fujiy/ModularNixie/hardware/NixiePower.brd

## EAGLE design hardware/NixiePower.brd (2020-12-17)

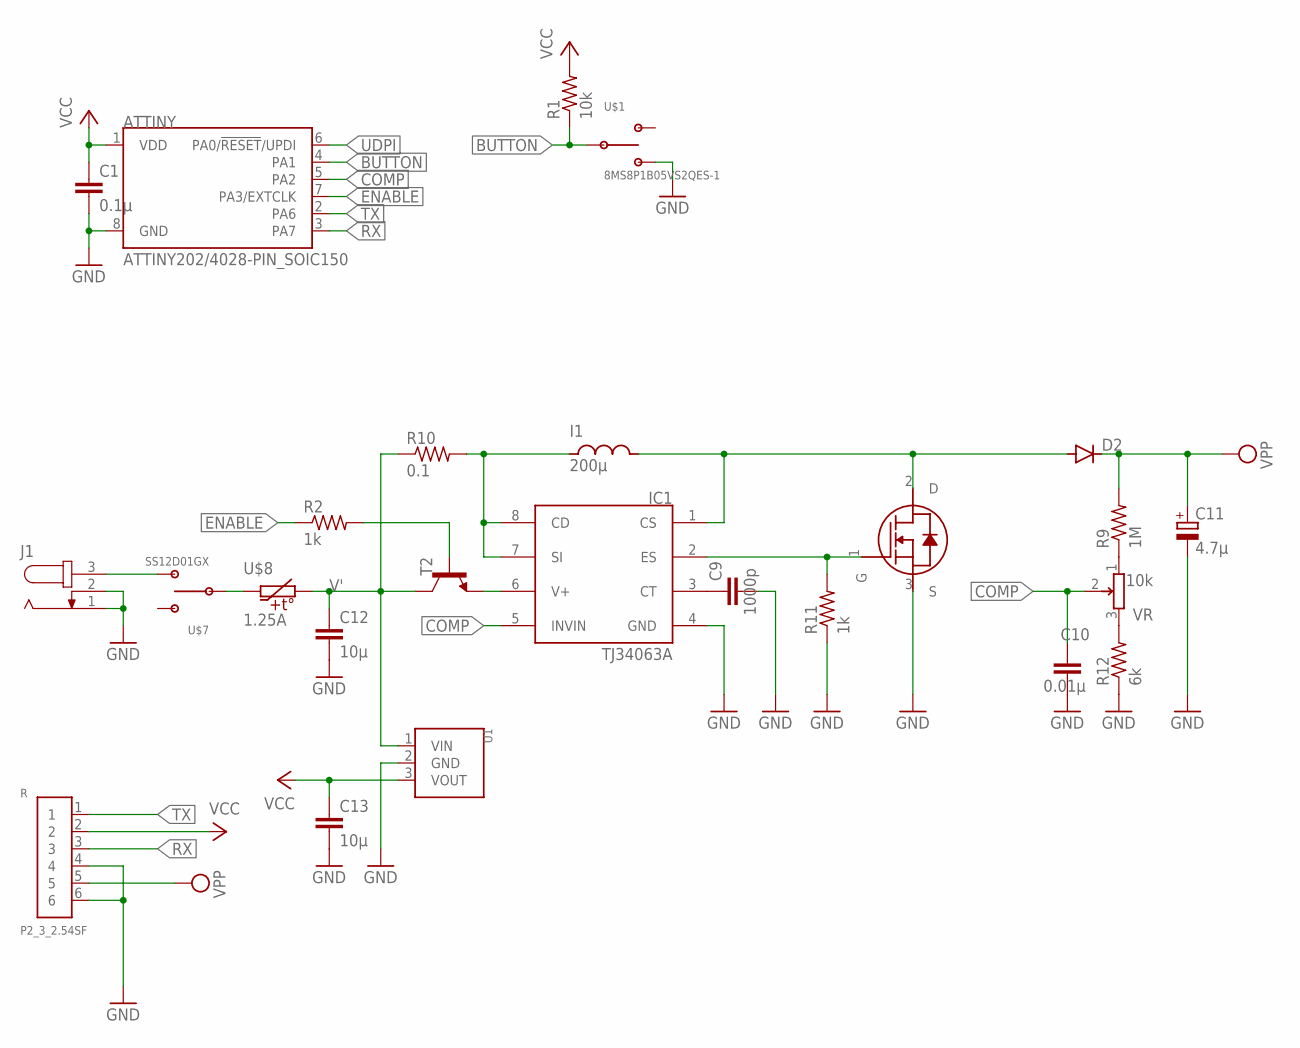
[picture p1: schematic NixiePower.sch]

Parts:
ATTINY: ATTINY202/4028-PIN_SOIC150; SOIC127P600X175-8N
C1: 0.1µ; C0603
C9: 1000p; C0603
C10: 0.01µ; C0603
C11: 4.7µ; E5-10,5
C12, C13: 10µ; C0603
D2: DIODE-DO15-12; DO15-12
I1: 200µ; NR10050
IC1: TJ34063A; SOP8
J1: JACK-PLUG1; SPC4078
R: P2_3_2.54SF
R1: 10k; R0603
R2, R11: 1k; R0603
R9: 1M; R0603
R10: 0.1; R0603
R12: 6k; R0603
T1: R6006AND; CPT3
T2: -NPN-SOT23-EBC; SOT23-EBC
U1: VX078XX-500
U$1: 8MS8P1B05VS2QES-1
U$7: SS12D01GX
U$8: 1.25A; SMD1812P
VR: 10k; RK09D

Connections:
BUTTON: ATTINY.4 (PA1), R1.1, U$1.2 (C)
COMP: ATTINY.5 (PA2), C10.1, IC1.5 (INVIN), VR.2
ENABLE: ATTINY.7 (PA3/EXTCLK), R2.1
GND: ATTINY.8 (GND), C1.2, C9.2, C10.2, C11.-, C12.2, C13.2, IC1.4 (GND), J1.1, J1.2, R.4, R.6, R11.1, R12.1, T1.3 (S), U1.2 (GND), U$1.3 (B)
unnamed: IC1.6 (V+), T2.E
unnamed: R2.2, T2.B
unnamed: U$7.2 (C), U$8.1
unnamed: J1.3, U$7.3 (B)
unnamed: D2.A, I1.2, IC1.1 (CS), T1.2 (D)
unnamed: C9.1, IC1.3 (CT)
unnamed: I1.1, IC1.7 (SI), IC1.8 (CD), R10.2
unnamed: IC1.2 (ES), R11.2, T1.1 (G)
unnamed: R9.1, VR.1 (3)
unnamed: R12.2, VR.3 (1)
RX: ATTINY.3 (PA7), R.3
TX: ATTINY.2 (PA6), R.1
UDPI: ATTINY.6 (PA0/!RESET!/UPDI)
V': C12.1, R10.1, T2.C, U1.1 (VIN), U$8.2
VCC: ATTINY.1 (VDD), C1.1, C13.1, R.2, R1.2, U1.3 (VOUT)
VPP: C11.+, D2.C, R.5, R9.2

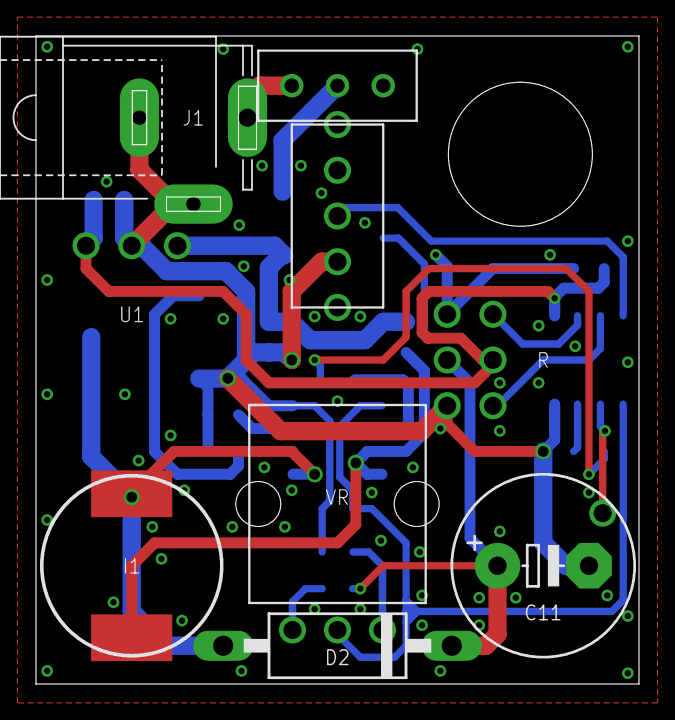
[picture p2: board NixiePower.brd from above]

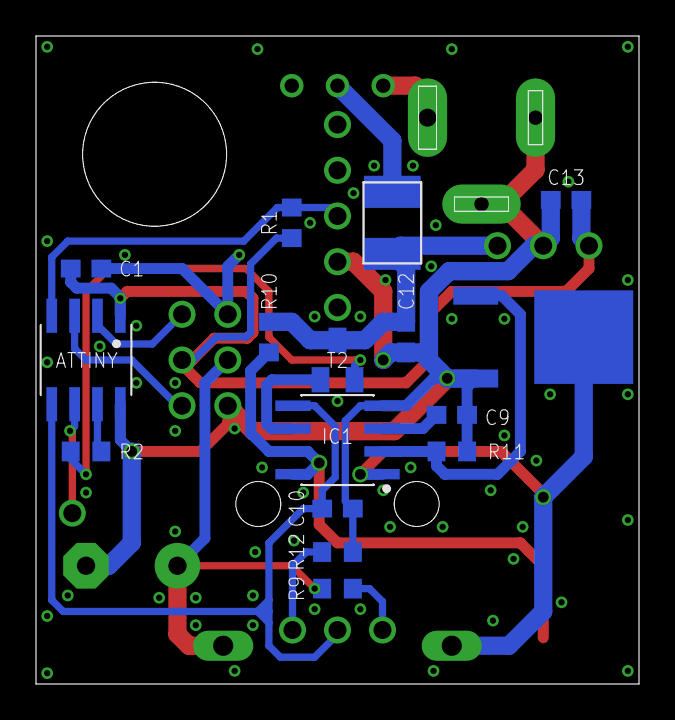
[picture p3: board NixiePower.brd from below]

Board: 2 copper layers, 33.5 x 36.0 mm, 25 parts (16 on the bottom side), 19 nets.
