fujiy/ModularNixie/hardware/IN-12.brd

## EAGLE design hardware/IN-12.brd (2020-12-09)

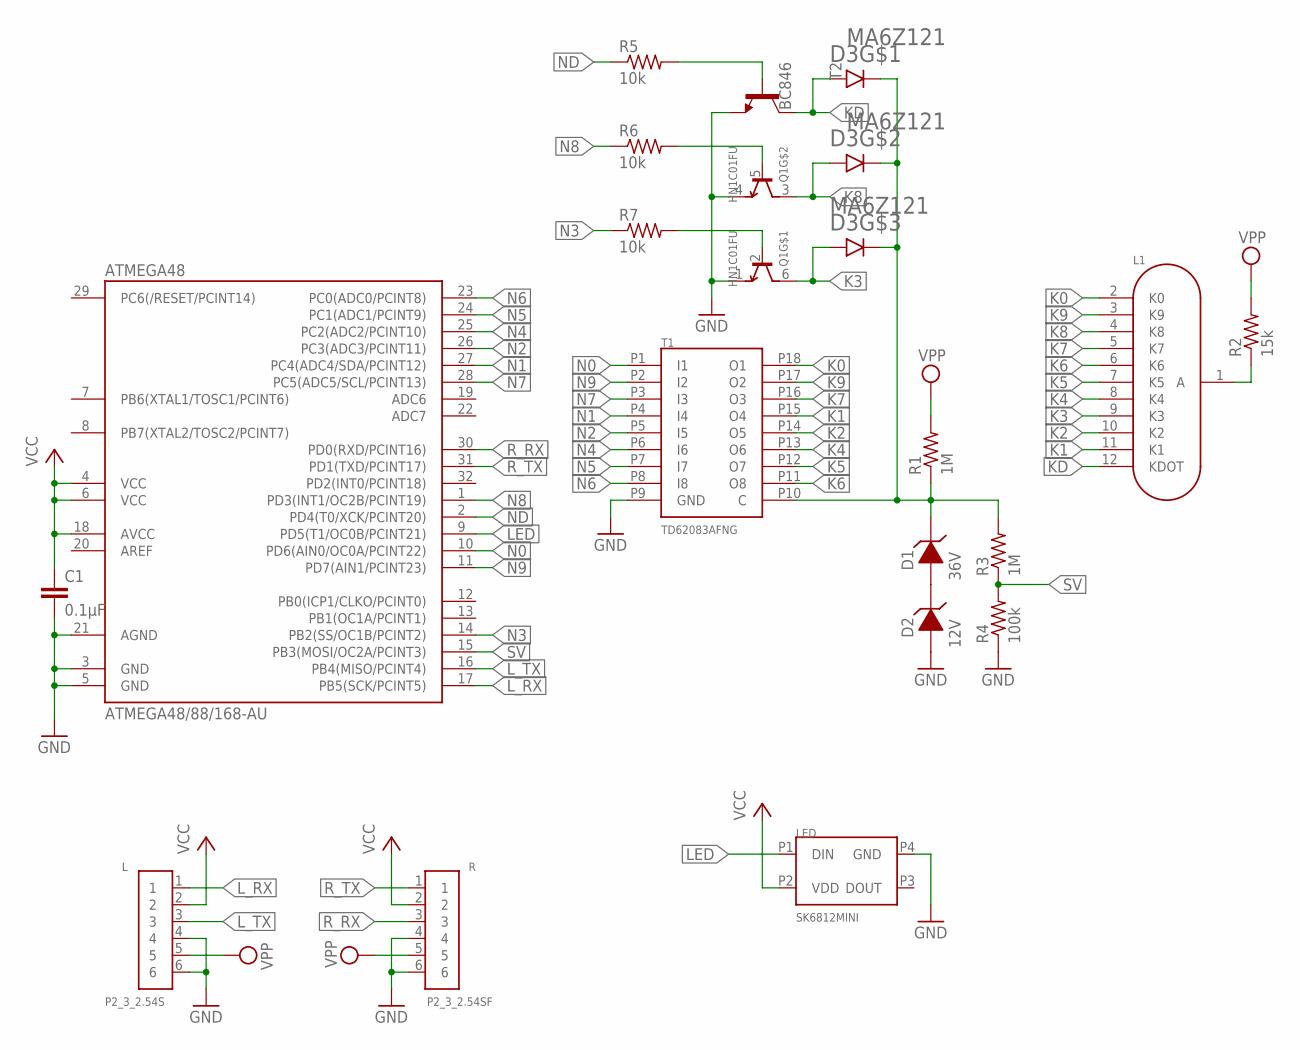
[picture p4: schematic IN-12.sch]

Parts:
ATMEGA48: ATMEGA48/88/168-AU; TQFP32-08
C1: 0.1µF; C0603
D1: 36V; S-MINI-2P
D2: 12V; S-MINI-2P
D3: MA6Z121; SMINI6-F1
L: P2_3_2.54S
L1: IN-12B_PS; IN-12_PS
LED: SK6812MINI; SK68XXMINI
Q1: HN1C01FU; SOT-363
R: P2_3_2.54SF
R1, R3: 1M; R0603
R2: 15k; R1206
R4: 100k; R0603
R5, R6, R7: 10k; R0603
T1: TD62083AFNG; SSOP18-P-225-0.65
T2: BC846; SOT23

Connections:
GND: ATMEGA48.3 (GND), ATMEGA48.5 (GND), ATMEGA48.21 (AGND), C1.2, D2.1 (A), L.4, L.6, LED.P4 (GND), Q1.1 (E), Q1.4 (E), R.4, R.6, R4.1, T1.P9 (GND), T2.2 (E)
K0: L1.2 (K0), T1.P18 (O1)
K1: L1.11 (K1), T1.P15 (O4)
K2: L1.10 (K2), T1.P14 (O5)
K3: D3.P3 (A), L1.9 (K3), Q1.6 (C)
K4: L1.8 (K4), T1.P13 (O6)
K5: L1.7 (K5), T1.P12 (O7)
K6: L1.6 (K6), T1.P11 (O8)
K7: L1.5 (K7), T1.P16 (O3)
K8: D3.P2 (A), L1.4 (K8), Q1.3 (C)
K9: L1.3 (K9), T1.P17 (O2)
KD: D3.P1 (A), L1.12 (KDOT), T2.3 (C)
LED: ATMEGA48.9 (PD5(T1/OC0B/PCINT21)), LED.P1 (DIN)
L_RX: ATMEGA48.17 (PB5(SCK/PCINT5)), L.1
L_TX: ATMEGA48.16 (PB4(MISO/PCINT4)), L.3
N0: ATMEGA48.10 (PD6(AIN0/OC0A/PCINT22)), T1.P1 (I1)
N1: ATMEGA48.27 (PC4(ADC4/SDA/PCINT12)), T1.P4 (I4)
N2: ATMEGA48.26 (PC3(ADC3/PCINT11)), T1.P5 (I5)
N3: ATMEGA48.14 (PB2(SS/OC1B/PCINT2)), R7.1
N4: ATMEGA48.25 (PC2(ADC2/PCINT10)), T1.P6 (I6)
N5: ATMEGA48.24 (PC1(ADC1/PCINT9)), T1.P7 (I7)
N6: ATMEGA48.23 (PC0(ADC0/PCINT8)), T1.P8 (I8)
N7: ATMEGA48.28 (PC5(ADC5/SCL/PCINT13)), T1.P3 (I3)
N8: ATMEGA48.1 (PD3(INT1/OC2B/PCINT19)), R6.1
N9: ATMEGA48.11 (PD7(AIN1/PCINT23)), T1.P2 (I2)
unnamed: D1.1 (A), D2.2 (C)
unnamed: D1.2 (C), D3.P4 (C), D3.P5 (C), D3.P6 (C), R1.1, R3.2, T1.P10 (C)
unnamed: L1.1 (A), R2.1
unnamed: Q1.2 (B), R7.2
unnamed: Q1.5 (B), R6.2
unnamed: R5.2, T2.1 (B)
ND: ATMEGA48.2 (PD4(T0/XCK/PCINT20)), R5.1
R_RX: ATMEGA48.30 (PD0(RXD/PCINT16)), R.3
R_TX: ATMEGA48.31 (PD1(TXD/PCINT17)), R.1
SV: ATMEGA48.15 (PB3(MOSI/OC2A/PCINT3)), R3.1, R4.2
VCC: ATMEGA48.4 (VCC), ATMEGA48.6 (VCC), ATMEGA48.18 (AVCC), C1.1, L.2, LED.P2 (VDD), R.2
VPP: L.5, R.5, R1.2, R2.2

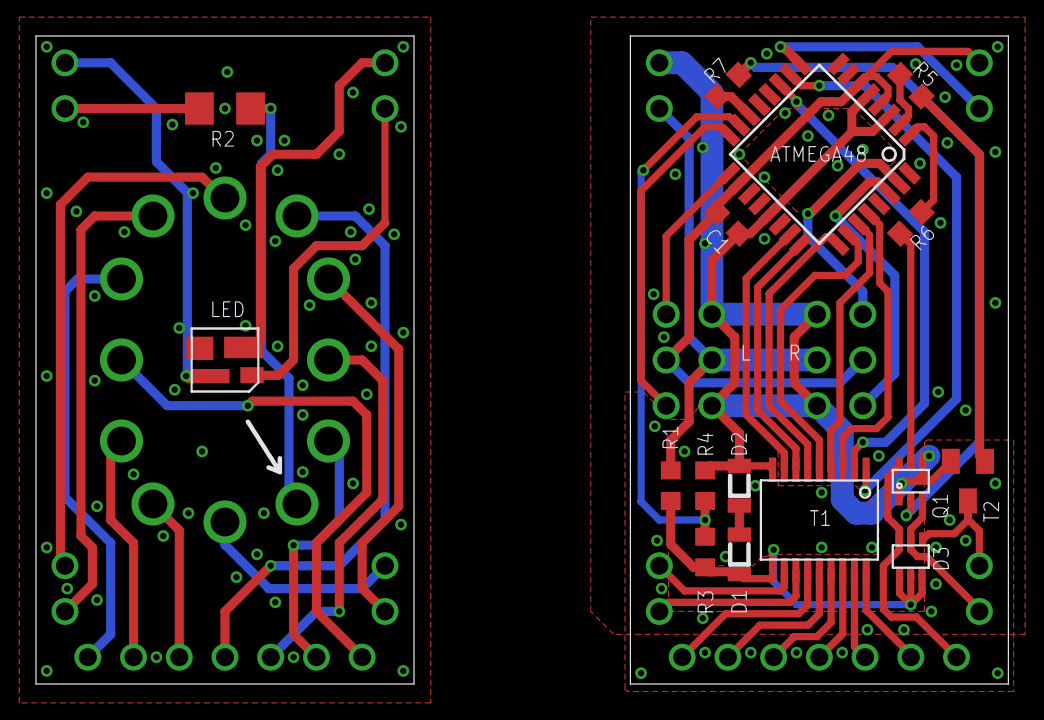
[picture p5: board IN-12.brd from above]

Board: 2 copper layers, 21.0 x 36.0 mm, 19 parts (1 on the bottom side), 37 nets.
