fujiy/ModularNixie/hardware/ColonRelay.brd

## EAGLE design hardware/ColonRelay.brd (2020-12-09)

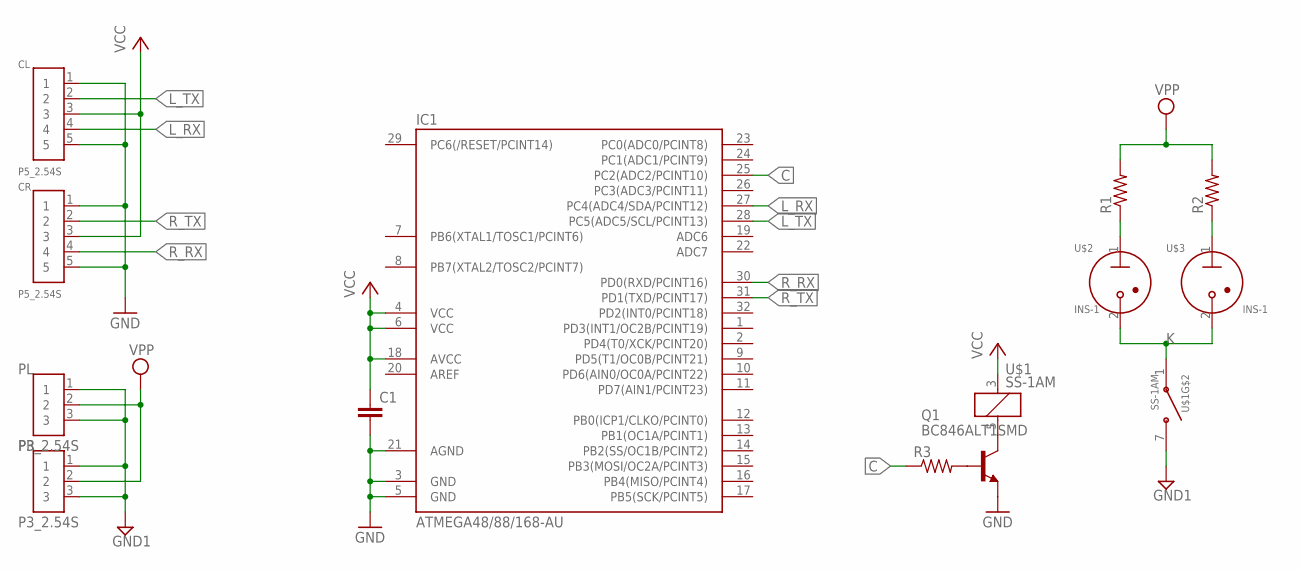
[picture p6: schematic ColonRelay.sch]

Parts:
C1: C-EUC0603K; C0603K
CL: P5_2.54S
CR: P5_2.54S
IC1: ATMEGA48/88/168-AU; TQFP32-08
PL: P3_2.54S
PR: P3_2.54S
Q1: BC846ALT1SMD; SOT23
R1, R2: R-US_R1206; R1206
R3: R-US_R0603; R0603
U$1: SS-1AM; SS-1****M
U$2, U$3: INS-1

Connections:
C: IC1.25 (PC2(ADC2/PCINT10)), R3.1
GND: C1.2, CL.1, CL.5, CR.1, CR.5, IC1.3 (GND), IC1.5 (GND), IC1.21 (AGND), Q1.2 (E)
GND1: PL.1, PL.3, PR.1, PR.3, U$1.7
K: U$1.1, U$2.2 (C), U$3.2 (C)
L_RX: CL.4, IC1.27 (PC4(ADC4/SDA/PCINT12))
L_TX: CL.2, IC1.28 (PC5(ADC5/SCL/PCINT13))
unnamed: Q1.3 (C), U$1.5 (2)
unnamed: R2.1, U$3.1 (A)
unnamed: R1.1, U$2.1 (A)
unnamed: Q1.1 (B), R3.2
R_RX: CR.4, IC1.30 (PD0(RXD/PCINT16))
R_TX: CR.2, IC1.31 (PD1(TXD/PCINT17))
VCC: C1.1, CL.3, CR.3, IC1.4 (VCC), IC1.6 (VCC), IC1.18 (AVCC), U$1.3 (1)
VPP: PL.2, PR.2, R1.2, R2.2

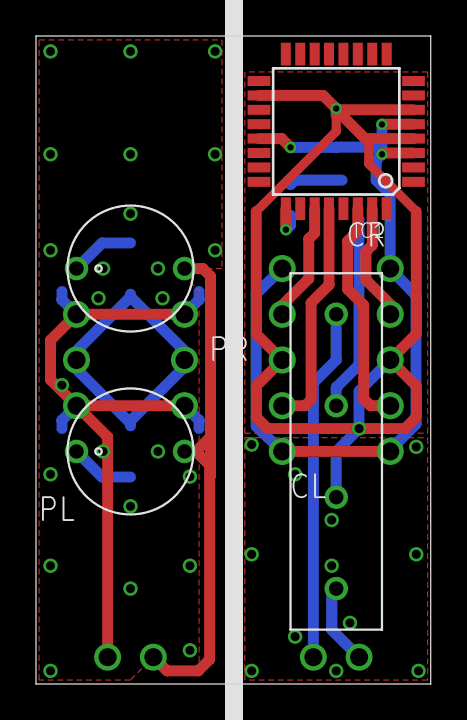
[picture p7: board ColonRelay.brd from above]

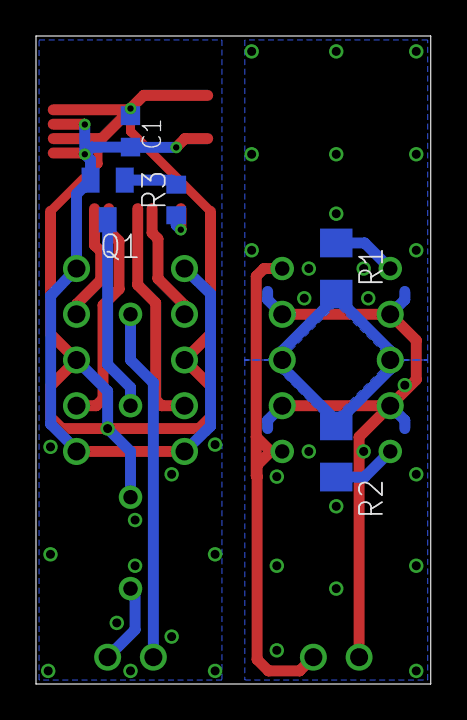
[picture p8: board ColonRelay.brd from below]

Board: 2 copper layers, 21.9 x 36.0 mm, 13 parts (5 on the bottom side), 14 nets.
