fujiy/ModularNixie/hardware/IN-12Relay.brd

## EAGLE design hardware/IN-12Relay.brd (2020-12-09)

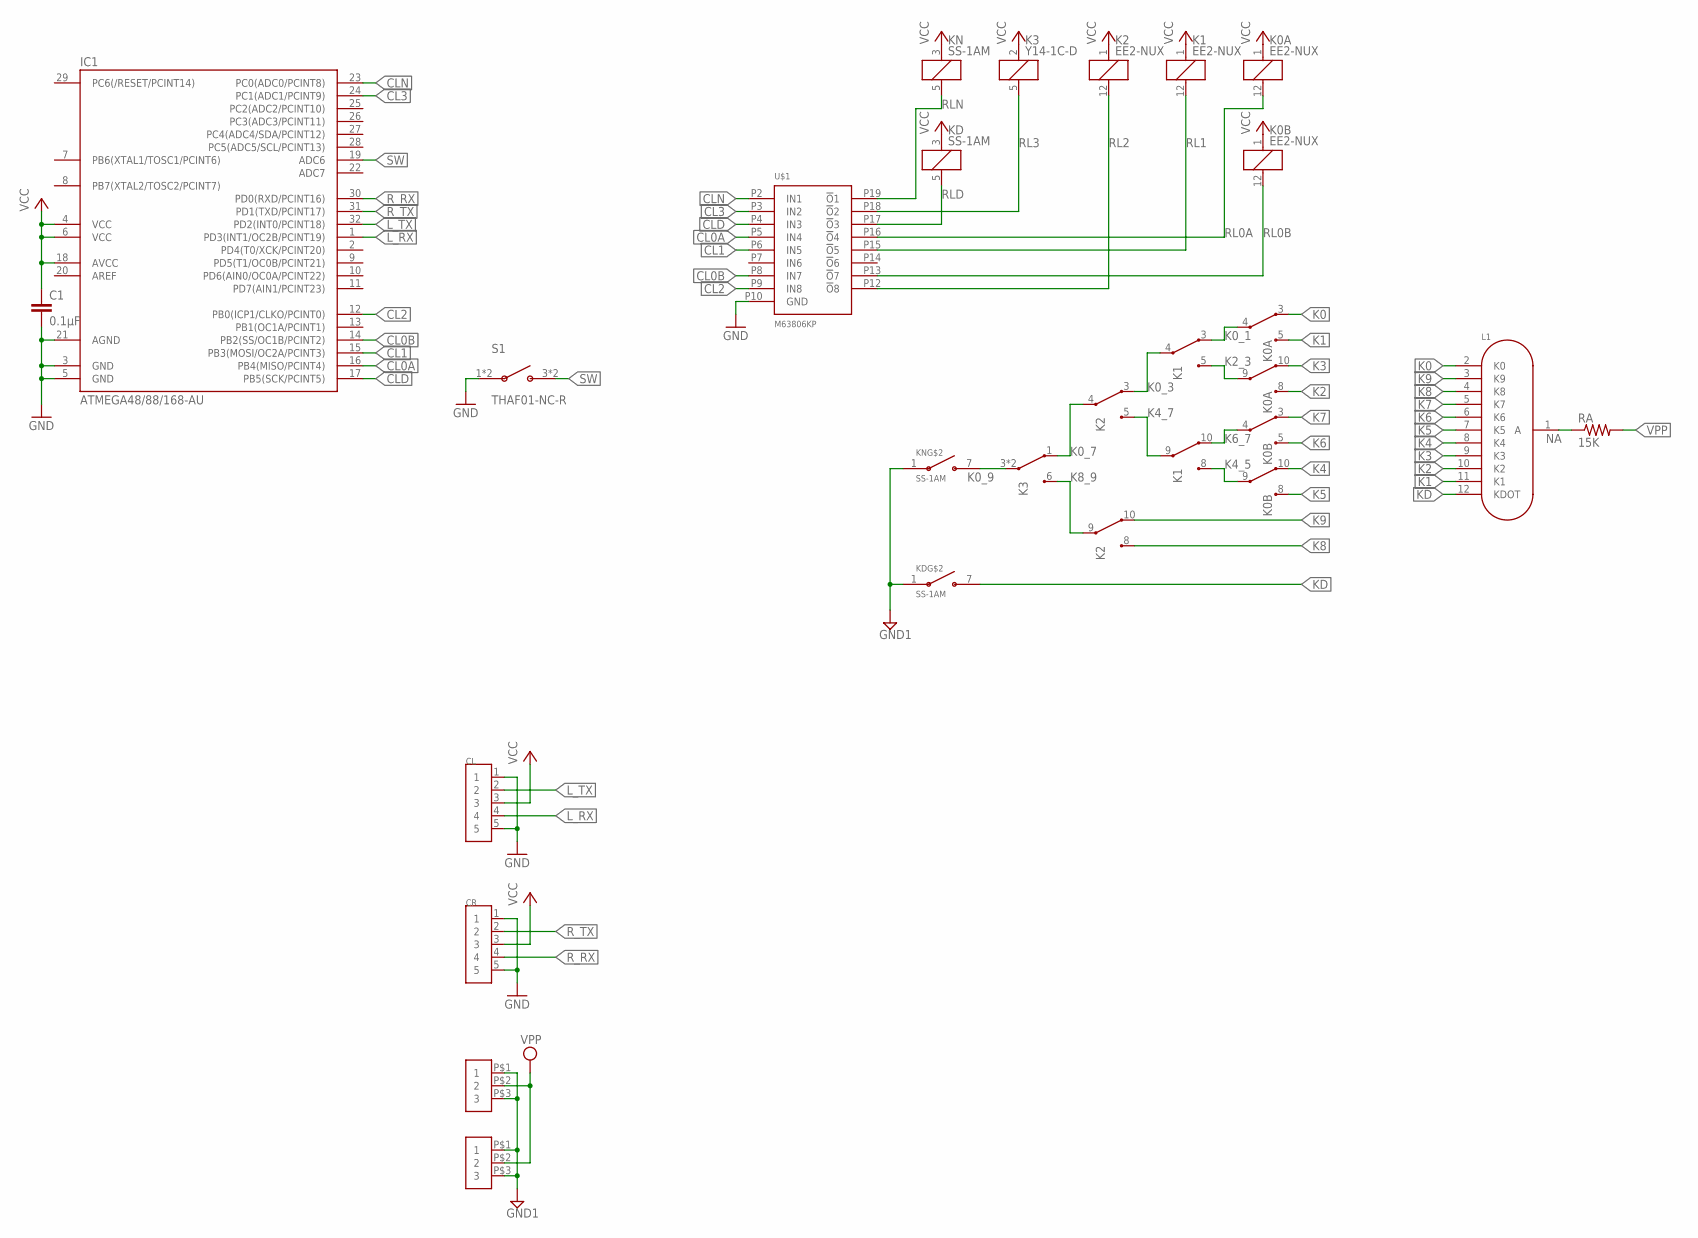
[picture p9: schematic IN-12Relay.sch]

Parts:
C1: 0.1µF; C0603K
CL: P5; P5_2.54
CR: P5; P5_2.54
IC1: ATMEGA48/88/168-AU; TQFP32-08
K0A, K0B, K1, K2: EE2-NUX; EE2-*NUX
K3: Y14-1C-D; Y14*-1C-*D*
KD: SS-1AM; SS-1****M
KN: SS-1AM; SS-1****M
L1: IN-12B_PS; IN-12_PS
PL: P3; P3_2.54
PR: P3; P3_2.54
RA: 15K; R1206
S1: THAF01-NC-R
U$1: M63806KP; 20P2E

Connections:
CL0A: IC1.16 (PB4(MISO/PCINT4)), U$1.P5 (IN4)
CL0B: IC1.14 (PB2(SS/OC1B/PCINT2)), U$1.P8 (IN7)
CL1: IC1.15 (PB3(MOSI/OC2A/PCINT3)), U$1.P6 (IN5)
CL2: IC1.12 (PB0(ICP1/CLKO/PCINT0)), U$1.P9 (IN8)
CL3: IC1.24 (PC1(ADC1/PCINT9)), U$1.P3 (IN2)
CLD: IC1.17 (PB5(SCK/PCINT5)), U$1.P4 (IN3)
CLN: IC1.23 (PC0(ADC0/PCINT8)), U$1.P2 (IN1)
GND: C1.2, CL.1, CL.5, CR.1, CR.5, IC1.3 (GND), IC1.5 (GND), IC1.21 (AGND), S1.1 (A), S1.2 (A), U$1.P10 (GND)
GND1: KD.1, KN.1, PL.P$1 (1), PL.P$3 (3), PR.P$1 (1), PR.P$3 (3)
K0: K0A.3 (S), L1.2 (K0)
K0_1: K0A.4, K1.3 (S)
K0_3: K1.4, K2.3 (S)
K0_7: K2.4, K3.1 (S)
K0_9: K3.3, K3.4, KN.7
K1: K0A.5 (O), L1.11 (K1)
K2: K0A.8 (O), L1.10 (K2)
K2_3: K0A.9, K1.5 (O)
K3: K0A.10 (S), L1.9 (K3)
K4: K0B.10 (S), L1.8 (K4)
K4_5: K0B.9, K1.8 (O)
K4_7: K1.9, K2.5 (O)
K5: K0B.8 (O), L1.7 (K5)
K6: K0B.5 (O), L1.6 (K6)
K6_7: K0B.4, K1.10 (S)
K7: K0B.3 (S), L1.5 (K7)
K8: K2.8 (O), L1.4 (K8)
K8_9: K2.9, K3.6 (O)
K9: K2.10 (S), L1.3 (K9)
KD: KD.7, L1.12 (KDOT)
L_RX: CL.4, IC1.1 (PD3(INT1/OC2B/PCINT19))
L_TX: CL.2, IC1.32 (PD2(INT0/PCINT18))
NA: L1.1 (A), RA.1
RL0A: K0A.12 (2), U$1.P16 (!O!4)
RL0B: K0B.12 (2), U$1.P13 (!O!7)
RL1: K1.12 (2), U$1.P15 (!O!5)
RL2: K2.12 (2), U$1.P12 (!O!8)
RL3: K3.5 (2), U$1.P18 (!O!2)
RLD: KD.5 (2), U$1.P17 (!O!3)
RLN: KN.5 (2), U$1.P19 (!O!1)
R_RX: CR.4, IC1.30 (PD0(RXD/PCINT16))
R_TX: CR.2, IC1.31 (PD1(TXD/PCINT17))
SW: IC1.19 (ADC6), S1.3 (B), S1.4 (B)
VCC: C1.1, CL.3, CR.3, IC1.4 (VCC), IC1.6 (VCC), IC1.18 (AVCC), K0A.1, K0B.1, K1.1, K2.1, K3.2 (1), KD.3 (1), KN.3 (1)
VPP: PL.P$2 (2), PR.P$2 (2), RA.2

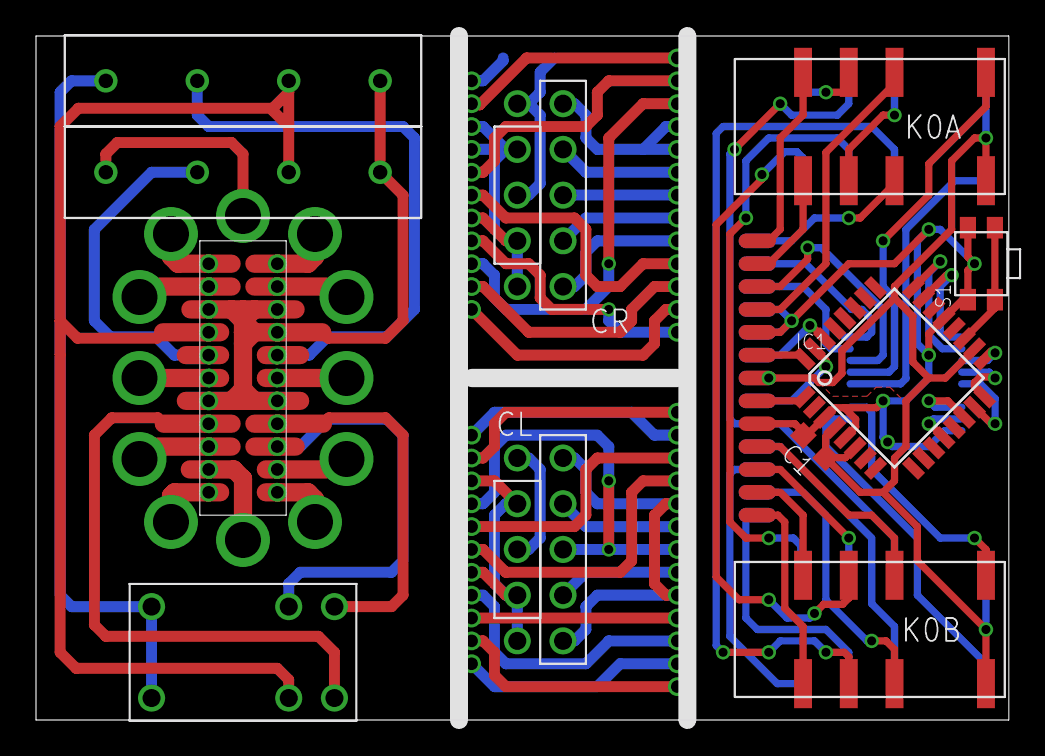
[picture p10: board IN-12Relay.brd from above]

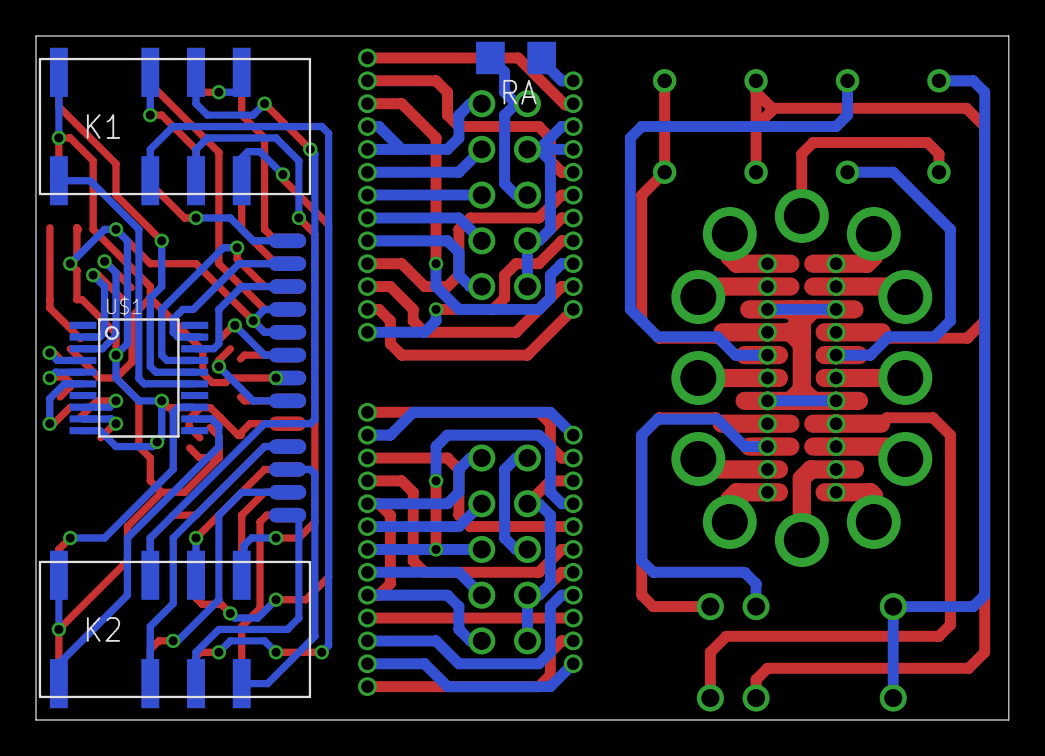
[picture p11: board IN-12Relay.brd from below]

Board: 2 copper layers, 54.0 x 38.0 mm, 17 parts (4 on the bottom side), 44 nets.
