fujiy/ModularNixie/hardware/Colon.brd

## EAGLE design hardware/Colon.brd (2020-12-09)

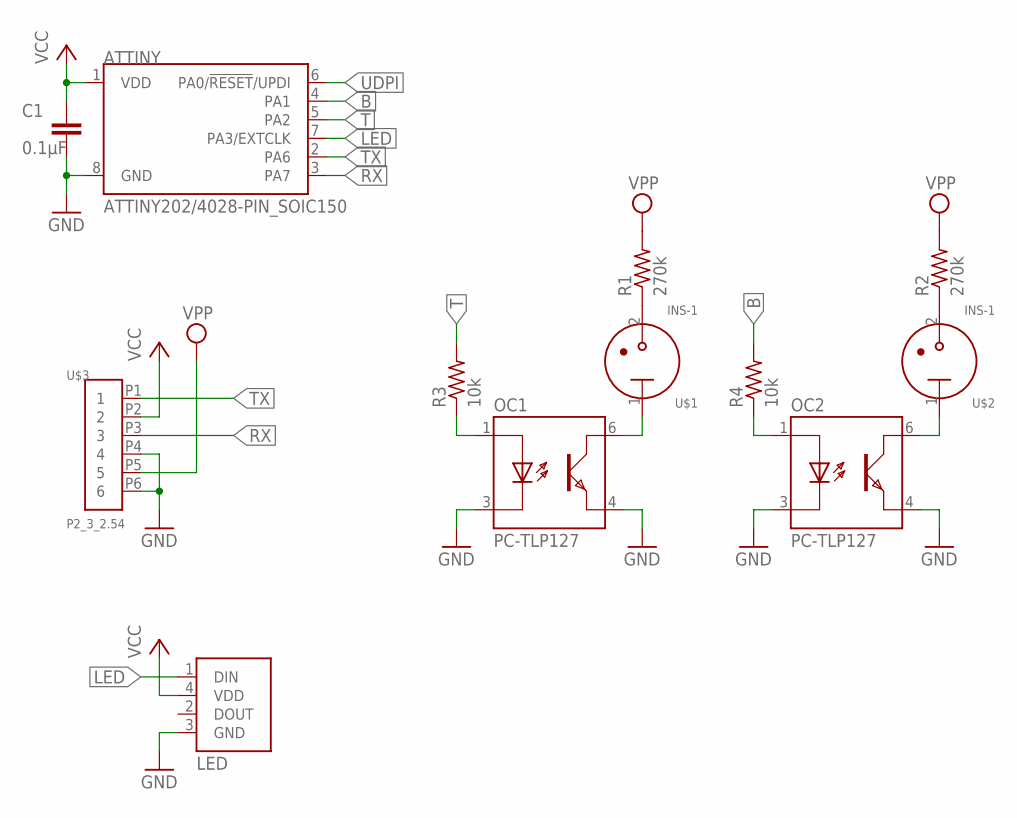
[picture p12: schematic Colon.sch]

Parts:
ATTINY: ATTINY202/4028-PIN_SOIC150; SOIC127P600X175-8N
C1: 0.1µF; C0603
LED: SK6812SIDE
OC1, OC2: PC-TLP127; MINIFLAT4
R1, R2: 270k; R0603
R3, R4: 10k; R0603
U$1, U$2: INS-1
U$3: P2_3_2.54

Connections:
B: ATTINY.4 (PA1), R4.2
GND: ATTINY.8 (GND), C1.2, LED.3 (GND), OC1.3 (C), OC1.4 (TE), OC2.3 (C), OC2.4 (TE), U$3.P4 (4), U$3.P6 (6)
LED: ATTINY.7 (PA3/EXTCLK), LED.1 (DIN)
unnamed: R1.1, U$1.2 (C)
unnamed: R2.1, U$2.2 (C)
unnamed: OC1.6 (TC), U$1.1 (A)
unnamed: OC2.6 (TC), U$2.1 (A)
unnamed: OC2.1 (A), R4.1
unnamed: OC1.1 (A), R3.1
RX: ATTINY.3 (PA7), U$3.P3 (3)
T: ATTINY.5 (PA2), R3.2
TX: ATTINY.2 (PA6), U$3.P1 (1)
UDPI: ATTINY.6 (PA0/!RESET!/UPDI)
VCC: ATTINY.1 (VDD), C1.1, LED.4 (VDD), U$3.P2 (2)
VPP: R1.2, R2.2, U$3.P5 (5)

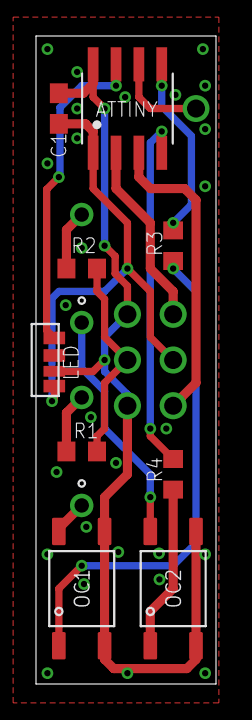
[picture p13: board Colon.brd from above]

Board: 2 copper layers, 10.0 x 36.0 mm, 12 parts (1 on the bottom side), 14 nets.
