fujiy/ModularNixie/hardware/Clock&Timer.brd

## EAGLE design hardware/Clock&Timer.brd (2020-12-09)

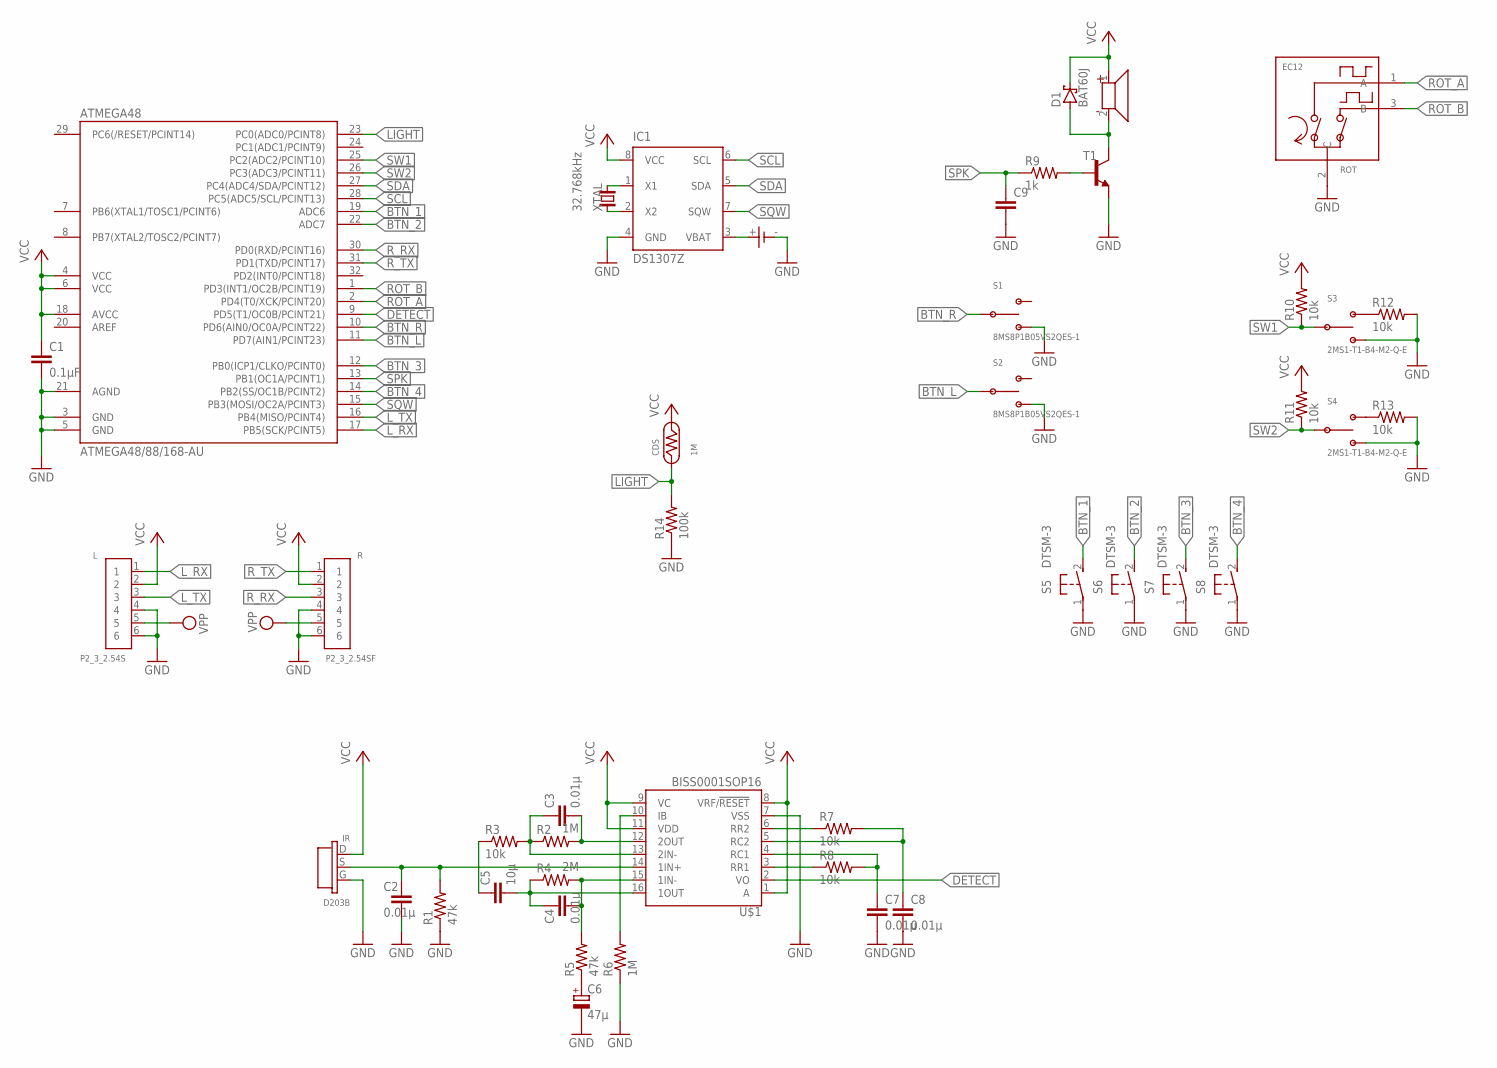
[picture p14: schematic Clock&Timer.sch]

Parts:
ATMEGA48: ATMEGA48/88/168-AU; TQFP32-08
BAT: BC1/3N
C1: 0.1µF; C0603
C2, C3, C4, C7, C8: 0.01µ; C0603
C5: 10µ; C0603
C6: 47µ; 153CLV-0605
C9: C-EUC0603; C0603
CDS: 1M; GL55
D1: BAT60J; SOD323_ST
IC1: DS1307Z; SOIC8
IR: D203B
L: P2_3_2.54S
R: P2_3_2.54SF
R1, R5: 47k; R0603
R2, R6: 1M; R0603
R3, R7, R8, R10, R11, R12, R13: 10k; R0603
R4: 2M; R0603
R9: 1k; R0603
R14: 100k; R0603
ROT: EC12
S1, S2: 8MS8P1B05VS2QES-1
S3, S4: 2MS1-T1-B4-M2-Q-E
S5, S6, S7, S8: DTSM-3
T1: -NPN-SOT23-EBC; SOT23-EBC
U$1: BISS0001SOP16; SOP16
U$9: UGCM0903EPD
XTAL: 32.768kHz; FC-255

Connections:
BTN_1: ATMEGA48.19 (ADC6), S5.2
BTN_2: ATMEGA48.22 (ADC7), S6.2
BTN_3: ATMEGA48.12 (PB0(ICP1/CLKO/PCINT0)), S7.2
BTN_4: ATMEGA48.14 (PB2(SS/OC1B/PCINT2)), S8.2
BTN_L: ATMEGA48.11 (PD7(AIN1/PCINT23)), S2.2 (C)
BTN_R: ATMEGA48.10 (PD6(AIN0/OC0A/PCINT22)), S1.2 (C)
DETECT: ATMEGA48.9 (PD5(T1/OC0B/PCINT21)), U$1.2 (VO)
GND: ATMEGA48.3 (GND), ATMEGA48.5 (GND), ATMEGA48.21 (AGND), BAT.- (V-), C1.2, C2.2, C6.-, C7.2, C8.2, C9.2, IC1.4 (GND), IR.G (GND), L.4, L.6, R.4, R.6, R1.1, R6.1, R12.2, R13.2, R14.1, ROT.2 (C), S1.3 (B), S2.3 (B), S3.3 (B), S4.3 (B), S5.1, S6.1, S7.1, S8.1, T1.E, U$1.7 (VSS)
LIGHT: ATMEGA48.23 (PC0(ADC0/PCINT8)), CDS.1, R14.2
L_RX: ATMEGA48.17 (PB5(SCK/PCINT5)), L.1
L_TX: ATMEGA48.16 (PB4(MISO/PCINT4)), L.3
unnamed: C2.1, IR.S (OUTPUT), R1.2, U$1.14 (1IN+)
unnamed: C3.2, R2.2, U$1.12 (2OUT)
unnamed: C3.1, R2.1, R3.2, U$1.13 (2IN-)
unnamed: C4.2, R4.2, R5.2, U$1.15 (1IN-)
unnamed: C5.1, R3.1
unnamed: C4.1, C5.2, R4.1, U$1.16 (1OUT)
unnamed: C6.+, R5.1
unnamed: R6.2, U$1.10 (IB)
unnamed: R7.1, U$1.6 (RR2)
unnamed: C8.1, R7.2, U$1.5 (RC2)
unnamed: IC1.1 (X1), XTAL.2
unnamed: R8.1, U$1.3 (RR1)
unnamed: C7.1, R8.2, U$1.4 (RC1)
unnamed: D1.A, T1.C, U$9.2
unnamed: R9.2, T1.B
unnamed: IC1.2 (X2), XTAL.1
unnamed: R12.1, S3.1 (A)
unnamed: R13.1, S4.1 (A)
ROT_A: ATMEGA48.2 (PD4(T0/XCK/PCINT20)), ROT.1 (A)
ROT_B: ATMEGA48.1 (PD3(INT1/OC2B/PCINT19)), ROT.3 (B)
R_RX: ATMEGA48.30 (PD0(RXD/PCINT16)), R.3
R_TX: ATMEGA48.31 (PD1(TXD/PCINT17)), R.1
SCL: ATMEGA48.28 (PC5(ADC5/SCL/PCINT13)), IC1.6 (SCL)
SDA: ATMEGA48.27 (PC4(ADC4/SDA/PCINT12)), IC1.5 (SDA)
SPK: ATMEGA48.13 (PB1(OC1A/PCINT1)), C9.1, R9.1
SQW: ATMEGA48.15 (PB3(MOSI/OC2A/PCINT3)), IC1.7 (SQW)
SW1: ATMEGA48.25 (PC2(ADC2/PCINT10)), R10.1, S3.2 (C)
SW2: ATMEGA48.26 (PC3(ADC3/PCINT11)), R11.1, S4.2 (C)
VBAT: BAT.+ (V+), IC1.3 (VBAT)
VCC: ATMEGA48.4 (VCC), ATMEGA48.6 (VCC), ATMEGA48.18 (AVCC), C1.1, CDS.2, D1.C, IC1.8 (VCC), IR.D (VIN), L.2, R.2, R10.2, R11.2, U$1.1 (A), U$1.8 (VRF/!RESET!), U$1.9 (VC), U$1.11 (VDD), U$9.1
VPP: L.5, R.5

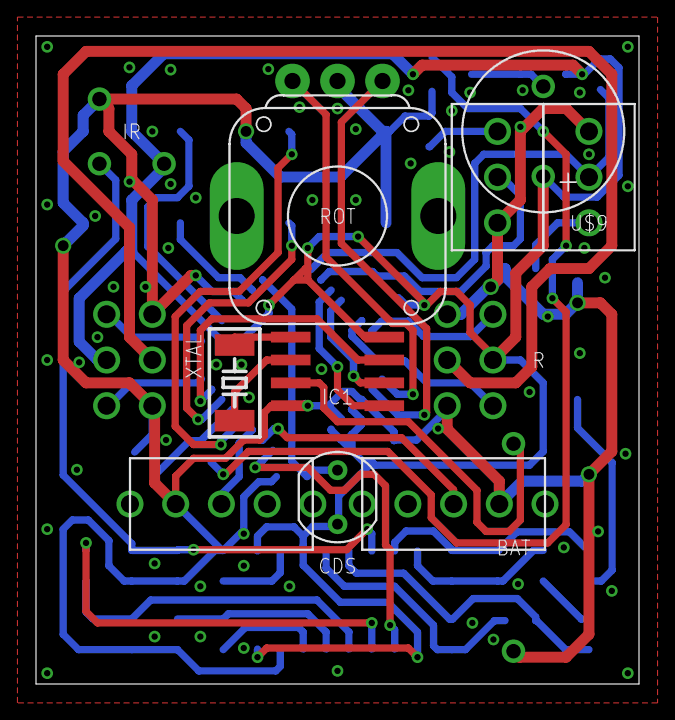
[picture p15: board Clock&Timer.brd from above]

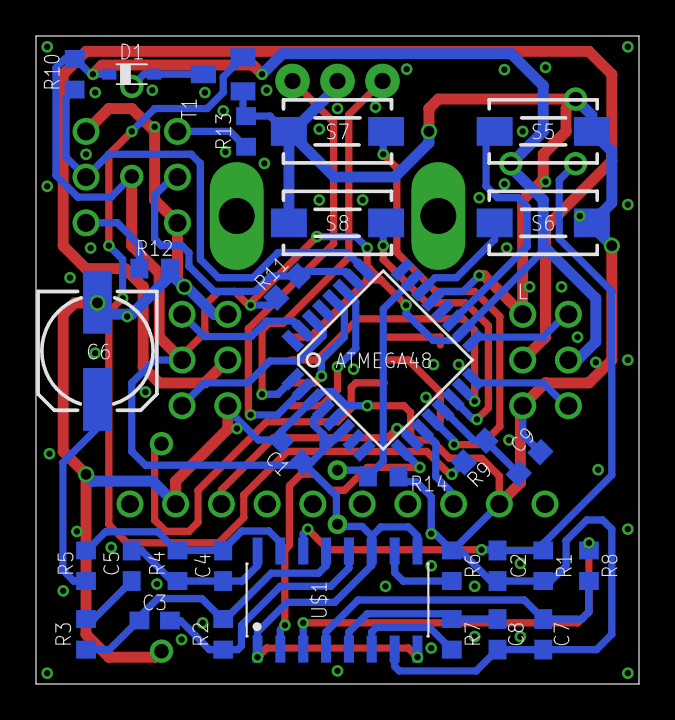
[picture p16: board Clock&Timer.brd from below]

Board: 2 copper layers, 33.5 x 36.0 mm, 44 parts (32 on the bottom side), 42 nets.
