fujiy/ModularNixie/hardware/IN-12_panelA.brd

## EAGLE design hardware/IN-12_panelA.brd (2020-12-09)

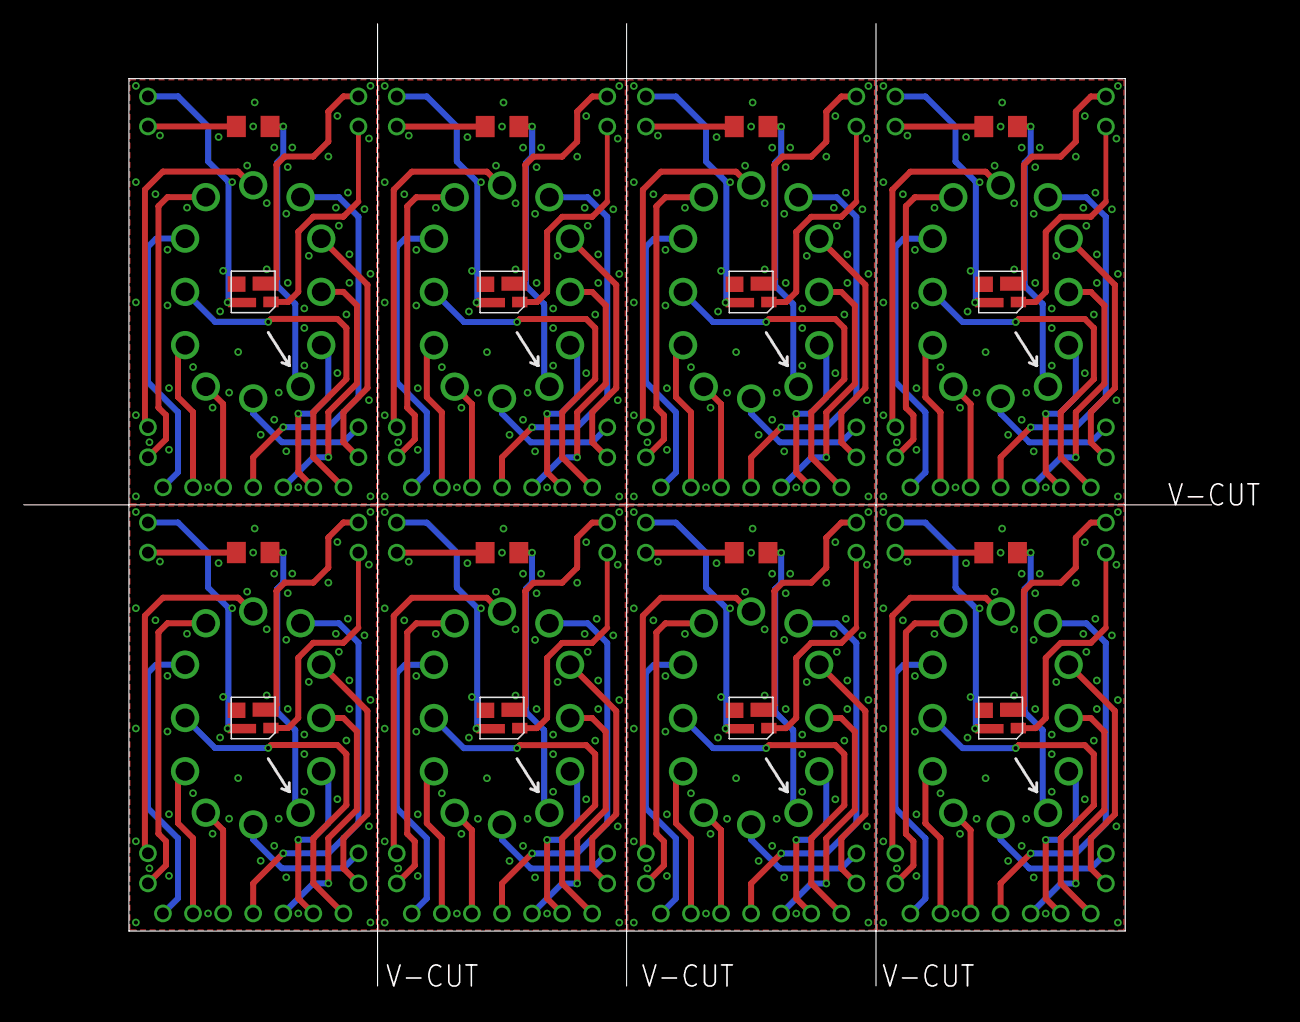
[picture p17: board IN-12_panelA.brd from above]

Board: 2 copper layers, 100.3 x 81.3 mm, 24 parts (0 on the bottom side), 8 nets.

Parts:
L1, L2, L3, L4, L5, L6, L7, L8: IN-12B_PS; IN-12_PS
LED, LED1, LED2, LED3, LED4, LED5, LED6, LED7: SK6812MINI; SK68XXMINI
R1, R2, R3, R4, R5, R6, R7, R8: 15k; R1206

Connections:
unnamed: L2.1, R1.1
unnamed: L3.1, R3.1
unnamed: L4.1, R4.1
unnamed: L5.1, R5.1
unnamed: L6.1, R6.1
unnamed: L7.1, R7.1
unnamed: L8.1, R8.1
unnamed: L1.1, R2.1
