fujiy/ModularNixie/hardware/IN-12_panelB.brd

## EAGLE design hardware/IN-12_panelB.brd (2020-12-09)

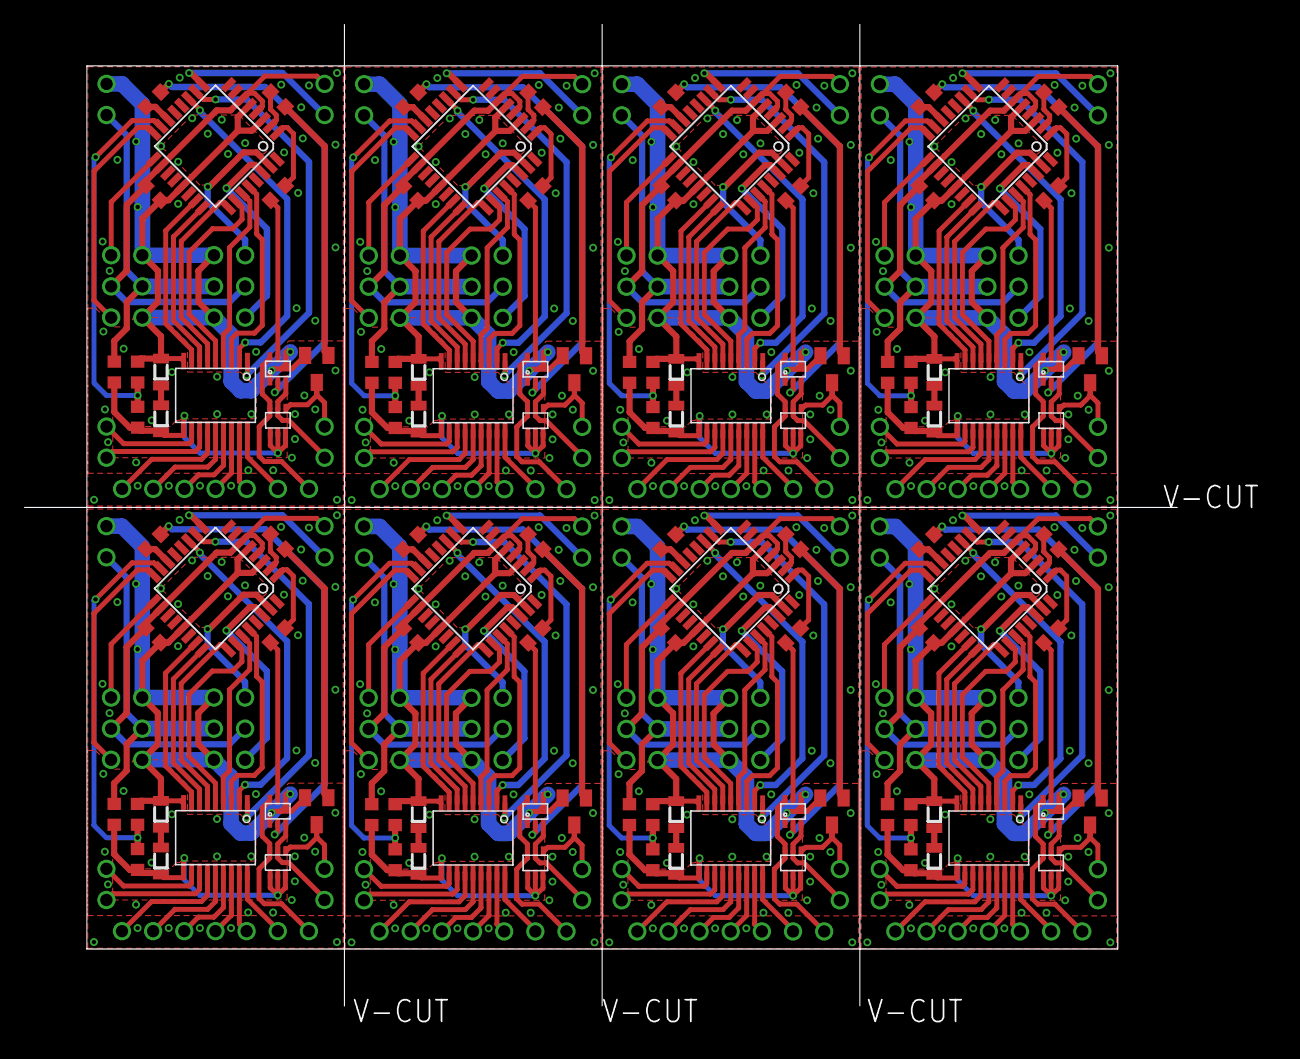
[picture p18: board IN-12_panelB.brd from above]

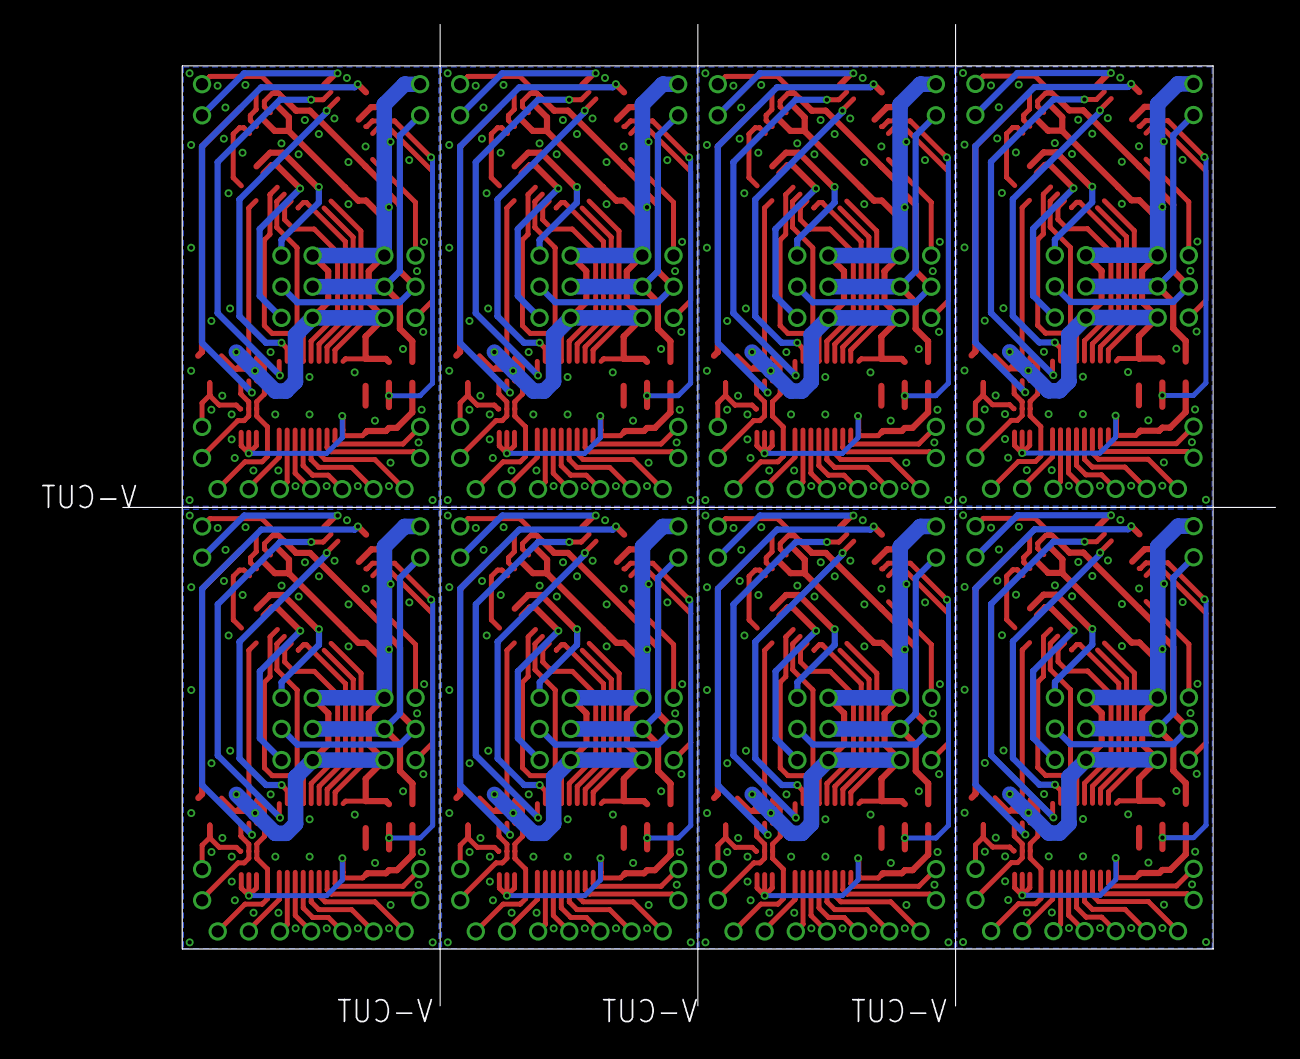
[picture p19: board IN-12_panelB.brd from below]

Board: 2 copper layers, 94.0 x 80.0 mm, 128 parts (8 on the bottom side), 216 nets.

Parts:
ATMEGA1, ATMEGA2, ATMEGA3, ATMEGA4, ATMEGA5, ATMEGA6, ATMEGA7, ATMEGA48: ATMEGA48/88/168-AU; TQFP32-08
C1, C2, C3, C4, C5, C6, C7, C8: 0.1µF; C0603
D1, D4, D7, D10, D13, D16, D19, D22: 36V; S-MINI-2P
D2, D5, D8, D11, D14, D17, D20, D23: 12V; S-MINI-2P
D3, D6, D9, D12, D15, D18, D21, D24: MA6Z121; SMINI6-F1
L, L1, L2, L3, L4, L5, L6, L7: P2_3_2.54S
Q1, Q2, Q3, Q4, Q5, Q6, Q7, Q8: HN1C01FU; SOT-363
R, R2, R14, R21, R28, R35, R42, R49: P2_3_2.54SF
R1, R3, R8, R9, R15, R16, R22, R23, R29, R30, R36, R37, R43, R44, R50, R51: 1M; R0603
R4, R10, R17, R24, R31, R38, R45, R52: 100k; R0603
R5, R6, R7, R11, R12, R13, R18, R19, R20, R25, R26, R27, R32, R33, R34, R39, R40, R41, R46, R47, R48, R53, R54, R55: 10k; R0603
T1, T3, T5, T7, T9, T11, T13, T15: TD62083AFNG; SSOP18-P-225-0.65
T2, T4, T6, T8, T10, T12, T14, T16: BC846; SOT23

Connections:
GND: ATMEGA48.3, ATMEGA48.5, ATMEGA48.21, C1.2, D2.1, L.4, L.6, Q1.1, Q1.4, R.4, R.6, R4.1, T1.P9, T2.2
GND1: ATMEGA1.3, ATMEGA1.5, ATMEGA1.21, C2.2, D5.1, L1.4, L1.6, Q2.1, Q2.4, R2.4, R2.6, R10.1, T3.P9, T4.2
GND2: ATMEGA2.3, ATMEGA2.5, ATMEGA2.21, C3.2, D8.1, L2.4, L2.6, Q3.1, Q3.4, R14.4, R14.6, R17.1, T5.P9, T6.2
GND3: ATMEGA3.3, ATMEGA3.5, ATMEGA3.21, C4.2, D11.1, L3.4, L3.6, Q4.1, Q4.4, R21.4, R21.6, R24.1, T7.P9, T8.2
GND4: ATMEGA4.3, ATMEGA4.5, ATMEGA4.21, C5.2, D14.1, L4.4, L4.6, Q5.1, Q5.4, R28.4, R28.6, R31.1, T9.P9, T10.2
GND5: ATMEGA5.3, ATMEGA5.5, ATMEGA5.21, C6.2, D17.1, L5.4, L5.6, Q6.1, Q6.4, R35.4, R35.6, R38.1, T11.P9, T12.2
GND6: ATMEGA6.3, ATMEGA6.5, ATMEGA6.21, C7.2, D20.1, L6.4, L6.6, Q7.1, Q7.4, R42.4, R42.6, R45.1, T13.P9, T14.2
GND7: ATMEGA7.3, ATMEGA7.5, ATMEGA7.21, C8.2, D23.1, L7.4, L7.6, Q8.1, Q8.4, R49.4, R49.6, R52.1, T15.P9, T16.2
K3: D3.P3, Q1.6
K8: D3.P2, Q1.3
K12: D6.P2, Q2.3
K17: D6.P3, Q2.6
K22: D9.P2, Q3.3
K27: D9.P3, Q3.6
K32: D12.P2, Q4.3
K37: D12.P3, Q4.6
K42: D15.P2, Q5.3
K47: D15.P3, Q5.6
K52: D18.P2, Q6.3
K57: D18.P3, Q6.6
K62: D21.P2, Q7.3
K67: D21.P3, Q7.6
K72: D24.P2, Q8.3
K77: D24.P3, Q8.6
KD: D3.P1, T2.3
KD1: D6.P1, T4.3
KD2: D9.P1, T6.3
KD3: D12.P1, T8.3
KD4: D15.P1, T10.3
KD5: D18.P1, T12.3
KD6: D21.P1, T14.3
KD7: D24.P1, T16.3
L_RX: ATMEGA48.17, L.1
L_RX1: ATMEGA1.17, L1.1
L_RX2: ATMEGA2.17, L2.1
L_RX3: ATMEGA3.17, L3.1
L_RX4: ATMEGA4.17, L4.1
L_RX5: ATMEGA5.17, L5.1
L_RX6: ATMEGA6.17, L6.1
L_RX7: ATMEGA7.17, L7.1
L_TX: ATMEGA48.16, L.3
L_TX1: ATMEGA1.16, L1.3
L_TX2: ATMEGA2.16, L2.3
L_TX3: ATMEGA3.16, L3.3
L_TX4: ATMEGA4.16, L4.3
L_TX5: ATMEGA5.16, L5.3
L_TX6: ATMEGA6.16, L6.3
L_TX7: ATMEGA7.16, L7.3
N0: ATMEGA48.10, T1.P1
N1: ATMEGA48.27, T1.P4
N2: ATMEGA48.26, T1.P5
N3: ATMEGA48.14, R7.1
N4: ATMEGA48.25, T1.P6
N5: ATMEGA48.24, T1.P7
N6: ATMEGA48.23, T1.P8
N7: ATMEGA48.28, T1.P3
N8: ATMEGA48.1, R6.1
N9: ATMEGA48.11, T1.P2
N10: ATMEGA1.23, T3.P8
N11: ATMEGA1.24, T3.P7
N12: ATMEGA1.26, T3.P5
N13: ATMEGA1.27, T3.P4
N14: ATMEGA1.28, T3.P3
N15: ATMEGA1.11, T3.P2
N16: ATMEGA1.10, T3.P1
N17: ATMEGA1.25, T3.P6
N18: ATMEGA1.1, R12.1
N19: ATMEGA1.14, R13.1
N20: ATMEGA2.23, T5.P8
N21: ATMEGA2.24, T5.P7
N22: ATMEGA2.26, T5.P5
N23: ATMEGA2.27, T5.P4
N24: ATMEGA2.28, T5.P3
N25: ATMEGA2.11, T5.P2
N26: ATMEGA2.10, T5.P1
N27: ATMEGA2.25, T5.P6
N28: ATMEGA2.1, R19.1
N29: ATMEGA2.14, R20.1
N30: ATMEGA3.23, T7.P8
N31: ATMEGA3.24, T7.P7
N32: ATMEGA3.26, T7.P5
N33: ATMEGA3.27, T7.P4
N34: ATMEGA3.28, T7.P3
N35: ATMEGA3.11, T7.P2
N36: ATMEGA3.10, T7.P1
N37: ATMEGA3.25, T7.P6
N38: ATMEGA3.1, R26.1
N39: ATMEGA3.14, R27.1
N40: ATMEGA4.23, T9.P8
N41: ATMEGA4.24, T9.P7
N42: ATMEGA4.26, T9.P5
N43: ATMEGA4.27, T9.P4
N44: ATMEGA4.28, T9.P3
N45: ATMEGA4.11, T9.P2
N46: ATMEGA4.10, T9.P1
N47: ATMEGA4.25, T9.P6
N48: ATMEGA4.1, R33.1
N49: ATMEGA4.14, R34.1
N50: ATMEGA5.23, T11.P8
N51: ATMEGA5.24, T11.P7
N52: ATMEGA5.26, T11.P5
N53: ATMEGA5.27, T11.P4
N54: ATMEGA5.28, T11.P3
N55: ATMEGA5.11, T11.P2
N56: ATMEGA5.10, T11.P1
N57: ATMEGA5.25, T11.P6
N58: ATMEGA5.1, R40.1
N59: ATMEGA5.14, R41.1
N60: ATMEGA6.23, T13.P8
N61: ATMEGA6.24, T13.P7
N62: ATMEGA6.26, T13.P5
N63: ATMEGA6.27, T13.P4
N64: ATMEGA6.28, T13.P3
N65: ATMEGA6.11, T13.P2
N66: ATMEGA6.10, T13.P1
N67: ATMEGA6.25, T13.P6
N68: ATMEGA6.1, R47.1
N69: ATMEGA6.14, R48.1
N70: ATMEGA7.23, T15.P8
N71: ATMEGA7.24, T15.P7
N72: ATMEGA7.26, T15.P5
N73: ATMEGA7.27, T15.P4
N74: ATMEGA7.28, T15.P3
N75: ATMEGA7.11, T15.P2
N76: ATMEGA7.10, T15.P1
N77: ATMEGA7.25, T15.P6
N78: ATMEGA7.1, R54.1
N79: ATMEGA7.14, R55.1
unnamed: D1.1, D2.2
unnamed: D1.2, D3.P4, D3.P5, D3.P6, R1.1, R3.2, T1.P10
unnamed: D4.1, D5.2
unnamed: D4.2, D6.P4, D6.P5, D6.P6, R8.1, R9.2, T3.P10
unnamed: Q2.2, R13.2
unnamed: Q2.5, R12.2
unnamed: R11.2, T4.1
unnamed: D7.1, D8.2
unnamed: D7.2, D9.P4, D9.P5, D9.P6, R15.1, R16.2, T5.P10
unnamed: Q3.2, R20.2
unnamed: Q3.5, R19.2
unnamed: Q1.2, R7.2
unnamed: R18.2, T6.1
unnamed: Q1.5, R6.2
unnamed: R5.2, T2.1
unnamed: D10.1, D11.2
unnamed: D10.2, D12.P4, D12.P5, D12.P6, R22.1, R23.2, T7.P10
unnamed: Q4.2, R27.2
unnamed: Q4.5, R26.2
unnamed: R25.2, T8.1
unnamed: D13.1, D14.2
unnamed: D13.2, D15.P4, D15.P5, D15.P6, R29.1, R30.2, T9.P10
unnamed: Q5.2, R34.2
unnamed: Q5.5, R33.2
unnamed: R32.2, T10.1
unnamed: D16.1, D17.2
unnamed: D16.2, D18.P4, D18.P5, D18.P6, R36.1, R37.2, T11.P10
unnamed: Q6.2, R41.2
unnamed: Q6.5, R40.2
unnamed: R39.2, T12.1
unnamed: D19.1, D20.2
unnamed: D19.2, D21.P4, D21.P5, D21.P6, R43.1, R44.2, T13.P10
unnamed: Q7.2, R48.2
unnamed: Q7.5, R47.2
unnamed: R46.2, T14.1
unnamed: D22.1, D23.2
unnamed: D22.2, D24.P4, D24.P5, D24.P6, R50.1, R51.2, T15.P10
unnamed: Q8.2, R55.2
unnamed: Q8.5, R54.2
unnamed: R53.2, T16.1
ND: ATMEGA48.2, R5.1
ND1: ATMEGA1.2, R11.1
ND2: ATMEGA2.2, R18.1
ND3: ATMEGA3.2, R25.1
ND4: ATMEGA4.2, R32.1
ND5: ATMEGA5.2, R39.1
ND6: ATMEGA6.2, R46.1
ND7: ATMEGA7.2, R53.1
R_RX: ATMEGA48.30, R.3
R_RX1: ATMEGA1.30, R2.3
R_RX2: ATMEGA2.30, R14.3
R_RX3: ATMEGA3.30, R21.3
R_RX4: ATMEGA4.30, R28.3
R_RX5: ATMEGA5.30, R35.3
R_RX6: ATMEGA6.30, R42.3
R_RX7: ATMEGA7.30, R49.3
R_TX: ATMEGA48.31, R.1
R_TX1: ATMEGA1.31, R2.1
R_TX2: ATMEGA2.31, R14.1
R_TX3: ATMEGA3.31, R21.1
R_TX4: ATMEGA4.31, R28.1
R_TX5: ATMEGA5.31, R35.1
R_TX6: ATMEGA6.31, R42.1
R_TX7: ATMEGA7.31, R49.1
SV: ATMEGA48.15, R3.1, R4.2
SV1: ATMEGA1.15, R9.1, R10.2
SV2: ATMEGA2.15, R16.1, R17.2
SV3: ATMEGA3.15, R23.1, R24.2
SV4: ATMEGA4.15, R30.1, R31.2
SV5: ATMEGA5.15, R37.1, R38.2
SV6: ATMEGA6.15, R44.1, R45.2
SV7: ATMEGA7.15, R51.1, R52.2
VCC: ATMEGA48.4, ATMEGA48.6, ATMEGA48.18, C1.1, L.2, R.2
VCC1: ATMEGA1.4, ATMEGA1.6, ATMEGA1.18, C2.1, L1.2, R2.2
VCC2: ATMEGA2.4, ATMEGA2.6, ATMEGA2.18, C3.1, L2.2, R14.2
VCC3: ATMEGA3.4, ATMEGA3.6, ATMEGA3.18, C4.1, L3.2, R21.2
VCC4: ATMEGA4.4, ATMEGA4.6, ATMEGA4.18, C5.1, L4.2, R28.2
VCC5: ATMEGA5.4, ATMEGA5.6, ATMEGA5.18, C6.1, L5.2, R35.2
VCC6: ATMEGA6.4, ATMEGA6.6, ATMEGA6.18, C7.1, L6.2, R42.2
VCC7: ATMEGA7.4, ATMEGA7.6, ATMEGA7.18, C8.1, L7.2, R49.2
VPP: L.5, R.5, R1.2
VPP1: L1.5, R2.5, R8.2
VPP2: L2.5, R14.5, R15.2
VPP3: L3.5, R21.5, R22.2
VPP4: L4.5, R28.5, R29.2
VPP5: L5.5, R35.5, R36.2
VPP6: L6.5, R42.5, R43.2
VPP7: L7.5, R49.5, R50.2
