fujiy/ModularNixie/(notices)

Notices in the files:
parts and their libraries:
m-pad-2.1: License : GNU General Public License version 2 (see bottom)
